hatlabs/SH-wg-hardware/README.md

# Sailor Hat WiFi Gateway

This repository contains the Sailor Hat WiFi Gateway (SH-wg) hardware design. SH-wg is a purpose-built NMEA 2000 WiFi gateway device.
