hatlabs/SH-wg-hardware/3d_models/m12_pcb_connector_1440054.stp

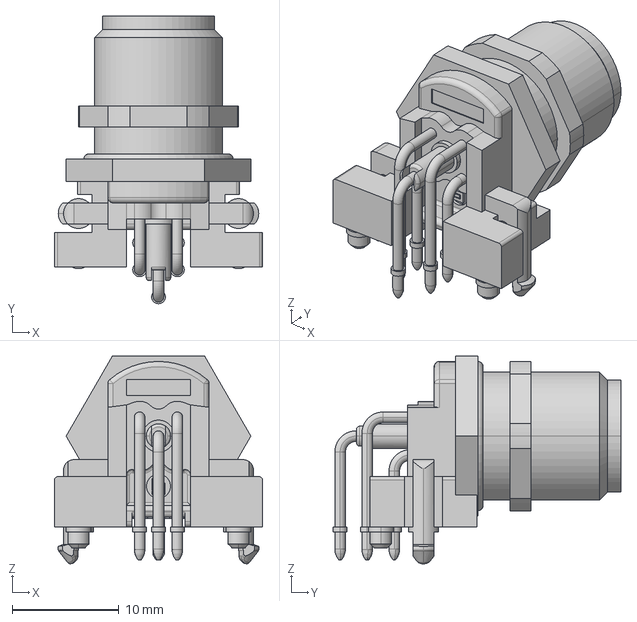
[picture p1: CAD file, 2022-01-28]
3d_models/m12_pcb_connector_1440054.stp
19.5 x 27.0 x 19.5 mm
