hatlabs/SH-wg-hardware/SH-wg.kicad_pcb

## KiCad design SH-wg.kicad_pcb (2022-03-17)

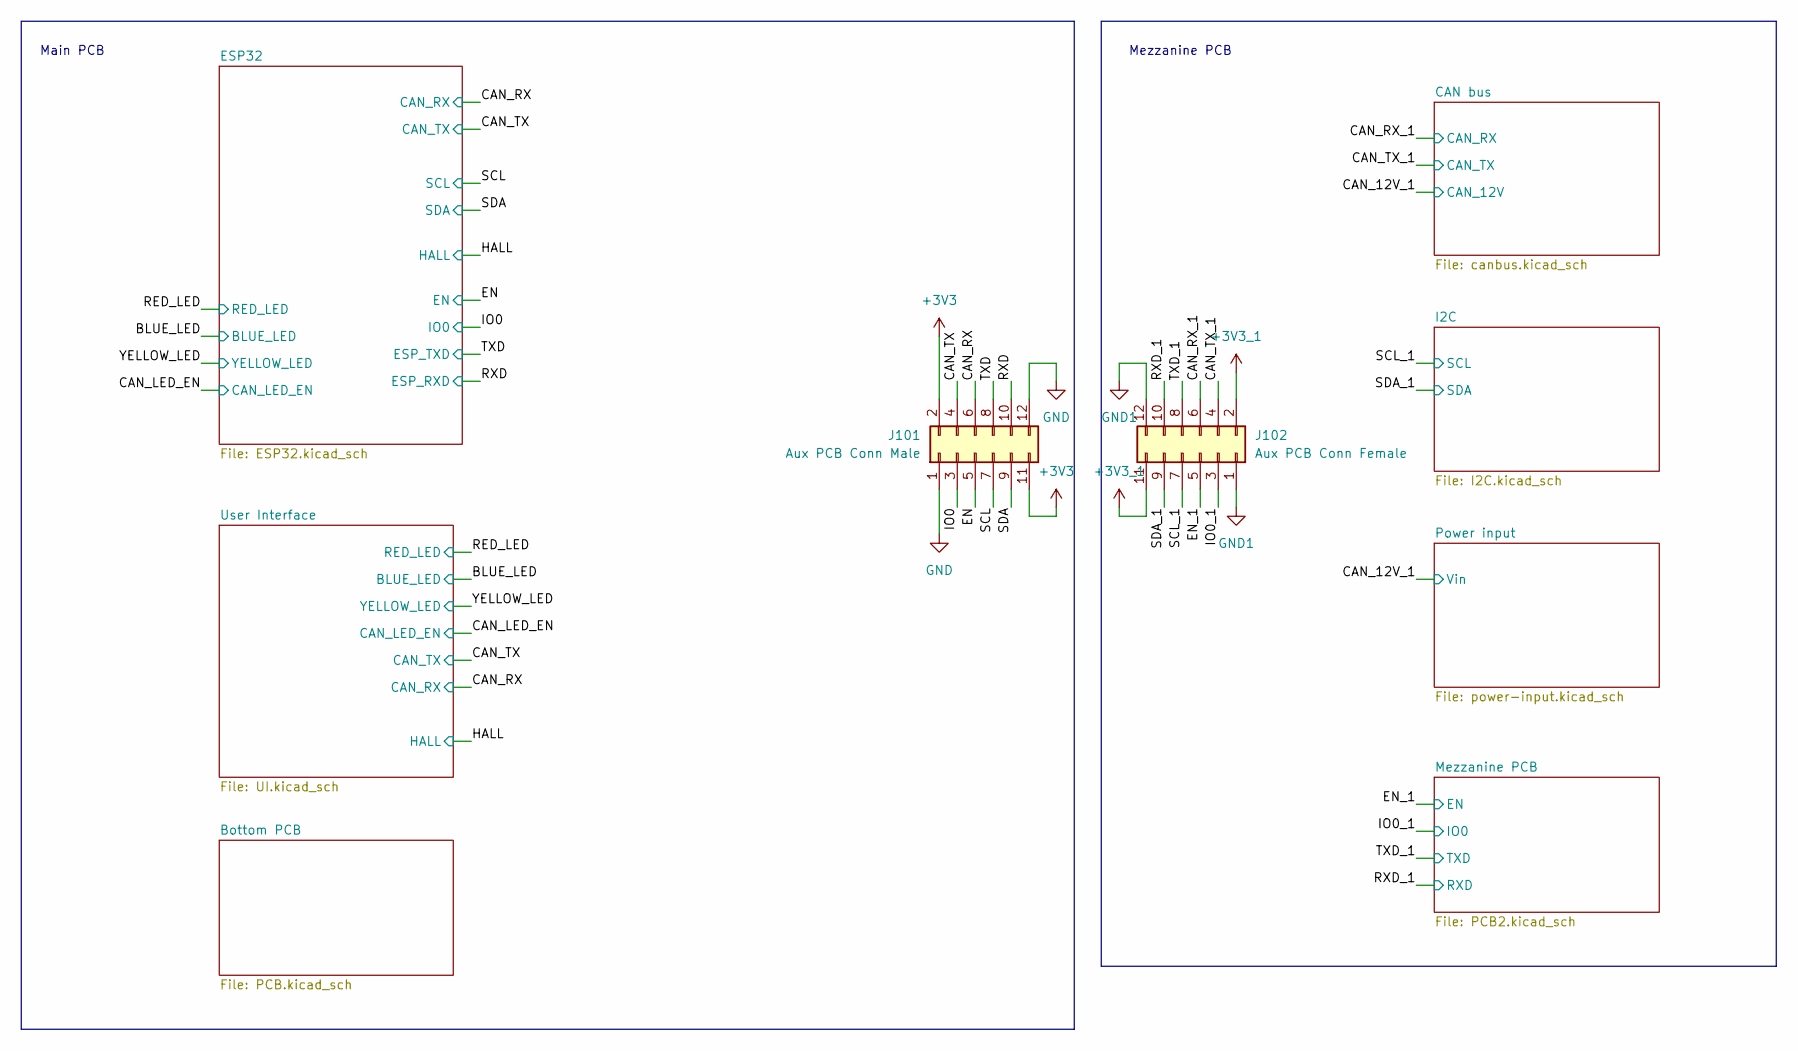
[picture p2: schematic SH-wg.kicad_sch, Sailor Hat WiFi Gateway]

Parts:
J101: Aux PCB Conn Male; PinHeader_2x06_P2.54mm_Vertical; LCSC C124388
J102: Aux PCB Conn Female; PinSocket_2x06_P2.54mm_Vertical; LCSC C36191

Connections:
+3V3_1: J102.2, J102.11; also elsewhere on the board
/CAN_RX: J101.6; also elsewhere on the board
/CAN_RX_1: J102.6; also elsewhere on the board
/CAN_TX: J101.4; also elsewhere on the board
/CAN_TX_1: J102.4; also elsewhere on the board
/EN: J101.5; also elsewhere on the board
/EN_1: J102.5; also elsewhere on the board
/IO0: J101.3; also elsewhere on the board
/IO0_1: J102.3; also elsewhere on the board
/RXD: J101.10; also elsewhere on the board
/RXD_1: J102.10; also elsewhere on the board
/SCL: J101.7; also elsewhere on the board
/SCL_1: J102.7; also elsewhere on the board
/SDA: J101.9; also elsewhere on the board
/SDA_1: J102.9; also elsewhere on the board
/TXD: J101.8; also elsewhere on the board
/TXD_1: J102.8; also elsewhere on the board
GND: J101.1, J101.12; also elsewhere on the board
GND1: J102.1, J102.12; also elsewhere on the board

Notes on the sheet:
Mezzanine PCB
Main PCB

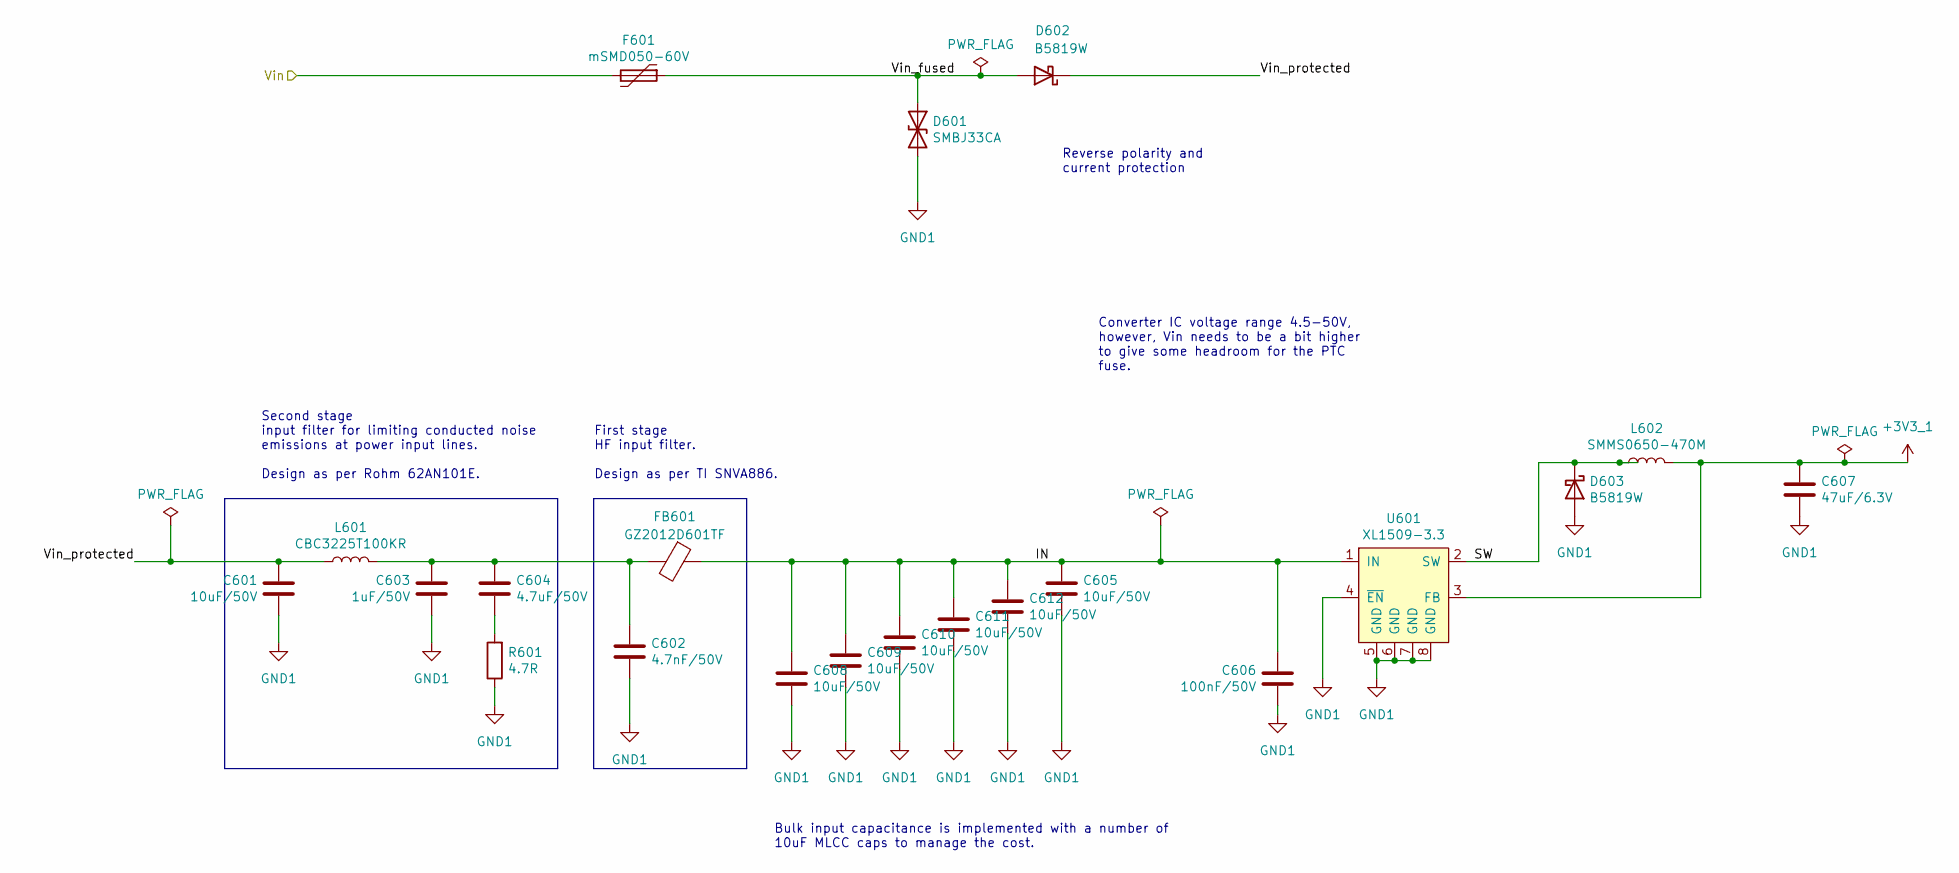
[picture p3: schematic power-input.kicad_sch, Sailor Hat WiFi Gateway]

Parts:
C601, C605, C608, C609, C610, C611, C612: 10uF/50V; C_1206_3216Metric; LCSC C13585
C602: 4.7nF/50V; C_0402_1005Metric; LCSC C1538
C603: 1uF/50V; C_0805_2012Metric; LCSC C215803
C604: 4.7uF/50V; C_1206_3216Metric; LCSC C29823
C606: 100nF/50V; C_0402_1005Metric; LCSC C307331
C607: 47uF/6.3V; C_1206_3216Metric; LCSC C96123
D601: SMBJ33CA; D_SMB; LCSC C114000
D602, D603: B5819W; D_SOD-123F; LCSC C8598
F601: mSMD050-60V; Fuse_1812_4532Metric; LCSC C70113
FB601: GZ2012D601TF; L_0805_2012Metric; LCSC C1017
L601: CBC3225T100KR; L_1210_3225Metric; LCSC C90321
L602: SMMS0650-470M; SMMS0650-1R0M; LCSC C149588
R601: 4.7R; R_0603_1608Metric; LCSC C23164
U601: XL1509-3.3; SOP-8_3.9x4.9mm_P1.27mm; LCSC C2681226

Connections:
+3V3_1: C607.1, L602.2, U601.3 (FB); also elsewhere on the board
/CAN_12V_1: F601.2; also elsewhere on the board
/Power input/IN: C605.1, C606.1, C608.1, C609.1, C610.1, C611.1, C612.1, FB601.1, U601.1 (IN)
/Power input/SW: D603.1 (K), L602.1, U601.2 (SW)
/Power input/Vin_fused: D601.1 (A1), D602.2 (A), F601.1
/Power input/Vin_protected: C601.2, D602.1 (K), L601.1
GND1: C601.1, C602.2, C603.1, C605.2, C606.2, C607.2, C608.2, C609.2, C610.2, C611.2, C612.2, D601.2 (A2), D603.2 (A), R601.1, U601.4 (~EN), U601.5 (GND), U601.6 (GND), U601.7 (GND), U601.8 (GND); also elsewhere on the board
unnamed: C602.1, C603.2, C604.1, FB601.2, L601.2
unnamed: C604.2, R601.2

Notes on the sheet:
Second stage input filter for limiting conducted noise emissions at power input lines. Design as per Rohm 62AN101E.
Converter IC voltage range 4.5-50V, however, Vin needs to be a bit higher to give some headroom for the PTC fuse.
First stage HF input filter. Design as per TI SNVA886.
Bulk input capacitance is implemented with a number of 10uF MLCC caps to manage the cost.
Reverse polarity and current protection

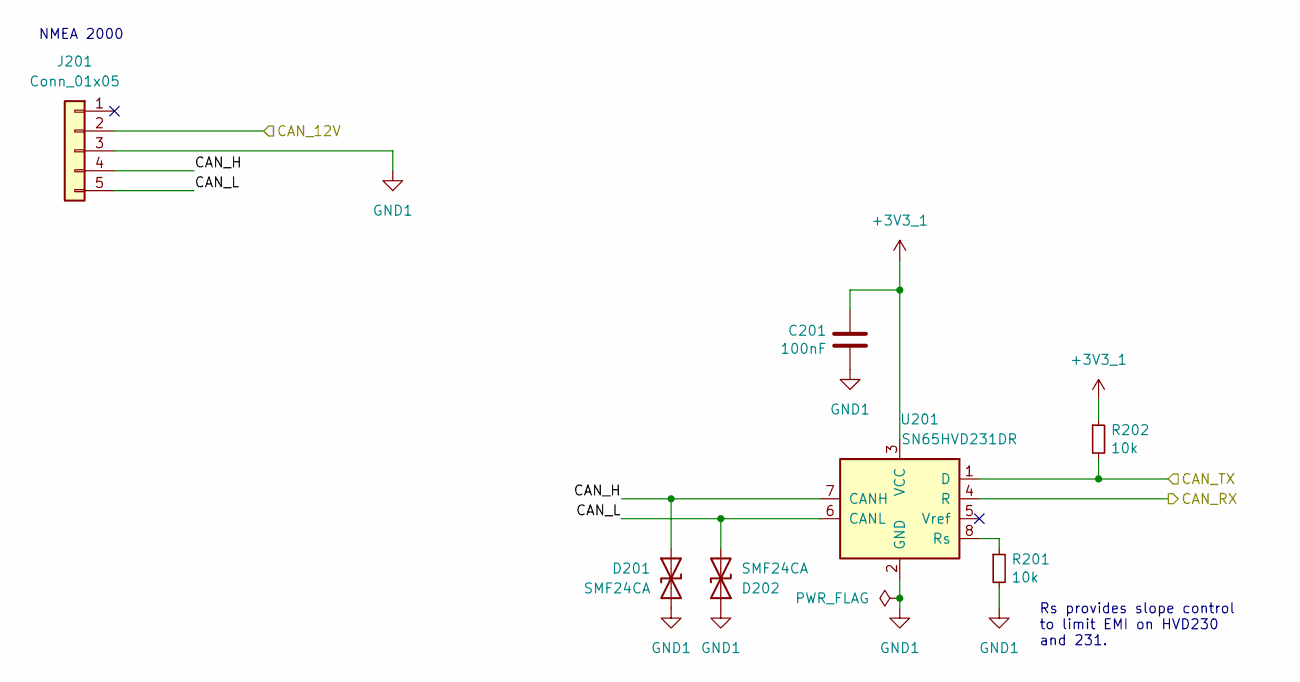
[picture p4: schematic canbus.kicad_sch, Sailor Hat WiFi Gateway]

Parts:
C201: 100nF; C_0402_1005Metric; LCSC C1525
D201, D202: SMF24CA; D_SOD-123F; LCSC C353294
J201: Conn_01x05; M12-5A_Male_Horizontal_PCB_Hysik
R201, R202: 10k; R_0402_1005Metric; LCSC C25744
U201: SN65HVD231DR; SOIC-8_3.9x4.9mm_P1.27mm; LCSC C129257

Connections:
+3V3_1: C201.1, R202.1, U201.3 (VCC); also elsewhere on the board
/CAN bus/CAN_H: D201.1 (A1), J201.4, U201.7 (CANH)
/CAN bus/CAN_L: D202.2 (A2), J201.5, U201.6 (CANL)
/CAN_12V_1: J201.2; also elsewhere on the board
/CAN_RX_1: U201.4 (R); also elsewhere on the board
/CAN_TX_1: R202.2, U201.1 (D); also elsewhere on the board
GND1: C201.2, D201.2 (A2), D202.1 (A1), J201.3, R201.2, U201.2 (GND); also elsewhere on the board
unnamed: R201.1, U201.8 (Rs)

Notes on the sheet:
Rs provides slope control to limit EMI on HVD230 and 231.
NMEA 2000

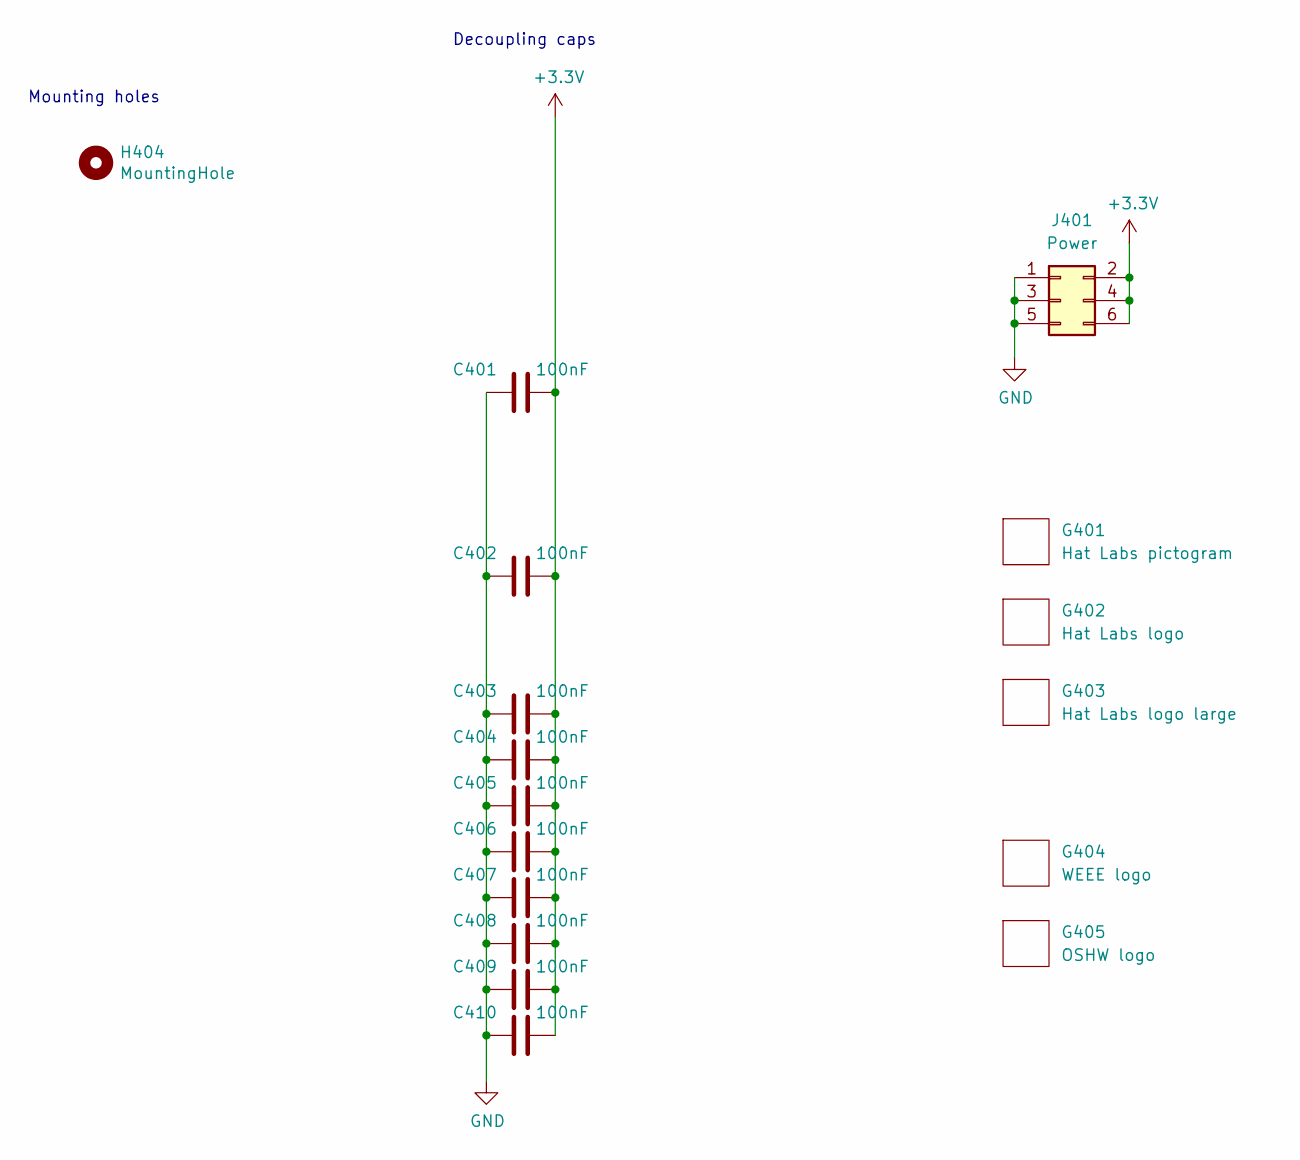
[picture p5: schematic PCB.kicad_sch, Sailor Hat WiFi Gateway]

Parts:
C401, C402, C403, C404, C405, C406, C407, C408, C409, C410: 100nF; C_0402_1005Metric; LCSC C1525
G401: Hat Labs pictogram; HL_pictogram_6.3mm
G402: Hat Labs logo; Hat_Labs_20mm
G403: Hat Labs logo large; Hat_Labs_25.4mm
G404: WEEE logo; WEEE-Logo_5.6x8mm_SilkScreen
G405: OSHW logo; OSHW-Logo2_9.8x8mm_SilkScreen
H404: MountingHole; MountingHole_3.2mm_M3_no_copper
J401: Power; PinHeader_2x03_P2.54mm_Vertical; LCSC C65114

Connections:
GND: C401.1, C402.1, C403.1, C404.1, C405.1, C406.1, C407.1, C408.1, C409.1, C410.1, J401.1, J401.3, J401.5; also elsewhere on the board

Notes on the sheet:
Mounting holes
Decoupling caps

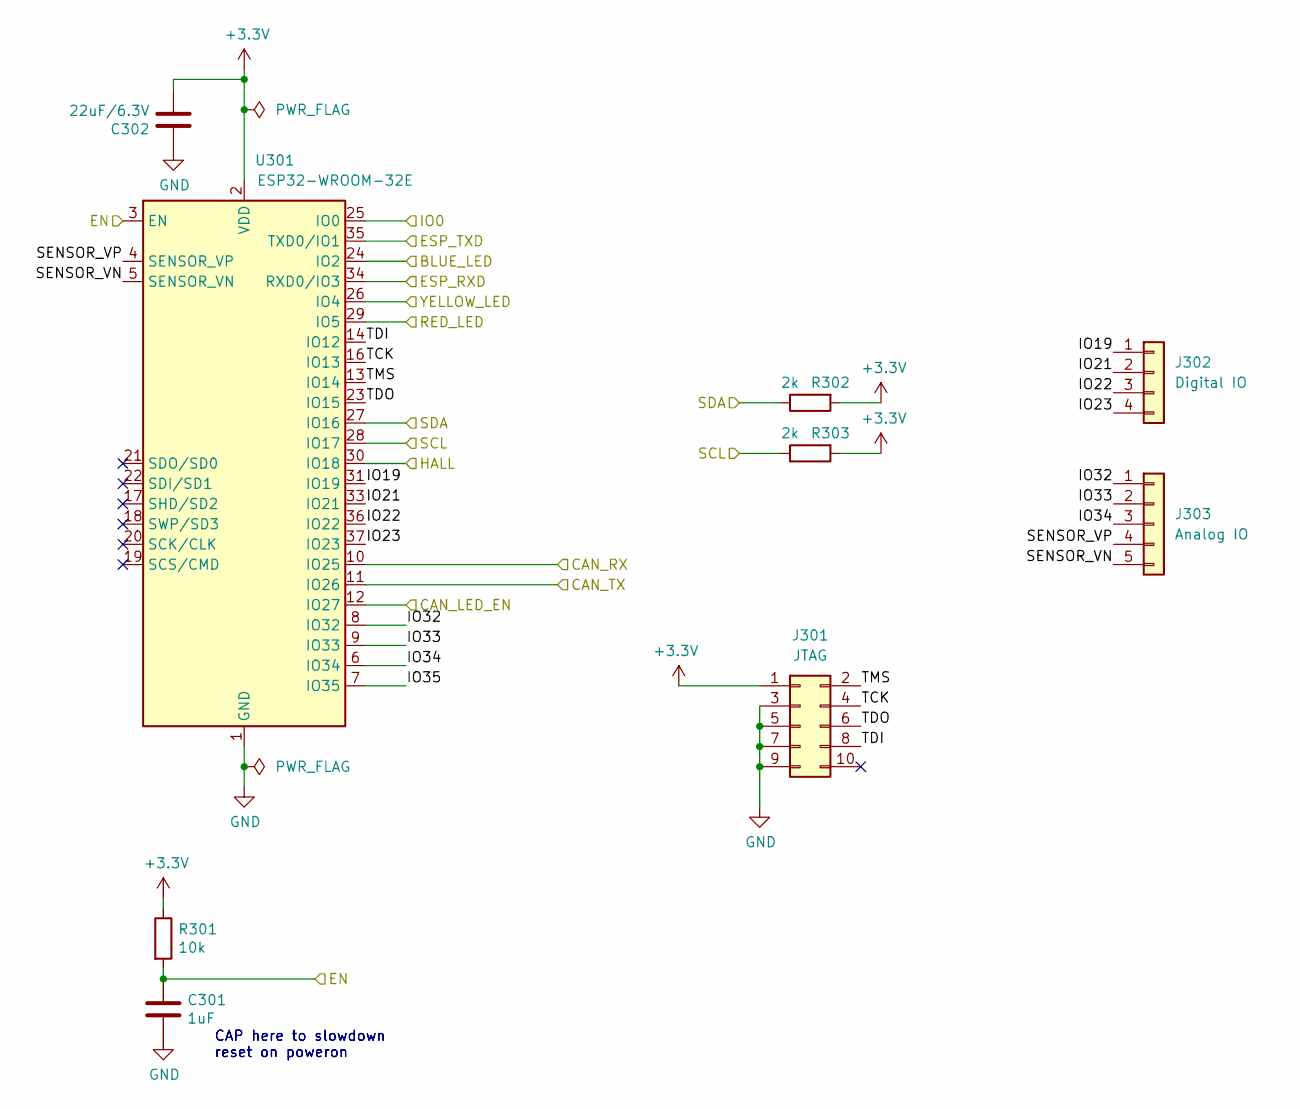
[picture p6: schematic ESP32.kicad_sch, Sailor Hat WiFi Gateway]

Parts:
C301: 1uF; C_0402_1005Metric; LCSC C52923
C302: 22uF/6.3V; C_0603_1608Metric; LCSC C59461
J301: JTAG; IDC-Header_2x05_P2.54mm_Vertical; LCSC C5665
J302: Digital IO; PinHeader_1x04_P2.54mm_Vertical; LCSC C358686
J303: Analog IO; PinHeader_1x05_P2.54mm_Vertical; LCSC C124379
R301: 10k; R_0402_1005Metric; LCSC C25744
R302, R303: 2k; R_0402_1005Metric; LCSC C4109
U301: ESP32-WROOM-32E; ESP32-WROOM-32-HandSolder; LCSC C701341

Connections:
/BLUE_LED: U301.24 (IO2); also elsewhere on the board
/CAN_LED_EN: U301.12 (IO27); also elsewhere on the board
/CAN_RX: U301.10 (IO25); also elsewhere on the board
/CAN_TX: U301.11 (IO26); also elsewhere on the board
/EN: C301.1, R301.2, U301.3 (EN); also elsewhere on the board
/ESP32/IO19: J302.1, U301.31 (IO19)
/ESP32/IO21: J302.2, U301.33 (IO21)
/ESP32/IO22: J302.3, U301.36 (IO22)
/ESP32/IO23: J302.4, U301.37 (IO23)
/ESP32/IO32: J303.1, U301.8 (IO32)
/ESP32/IO33: J303.2, U301.9 (IO33)
/ESP32/IO34: J303.3, U301.6 (IO34)
/ESP32/IO35: U301.7 (IO35)
/ESP32/SENSOR_VN: J303.5, U301.5 (SENSOR_VN)
/ESP32/SENSOR_VP: J303.4, U301.4 (SENSOR_VP)
/ESP32/TCK: J301.4, U301.16 (IO13)
/ESP32/TDI: J301.8, U301.14 (IO12)
/ESP32/TDO: J301.6, U301.23 (IO15)
/ESP32/TMS: J301.2, U301.13 (IO14)
/HALL: U301.30 (IO18); also elsewhere on the board
/IO0: U301.25 (IO0); also elsewhere on the board
/RED_LED: U301.29 (IO5); also elsewhere on the board
/RXD: U301.34 (RXD0/IO3); also elsewhere on the board
/SCL: R303.1, U301.28 (IO17); also elsewhere on the board
/SDA: R302.1, U301.27 (IO16); also elsewhere on the board
/TXD: U301.35 (TXD0/IO1); also elsewhere on the board
/YELLOW_LED: U301.26 (IO4); also elsewhere on the board
GND: C301.2, C302.1, J301.3, J301.5, J301.7, J301.9, U301.1 (GND), U301.15 (GND), U301.38 (GND), U301.39 (GND); also elsewhere on the board

Notes on the sheet:
CAP here to slowdown reset on poweron

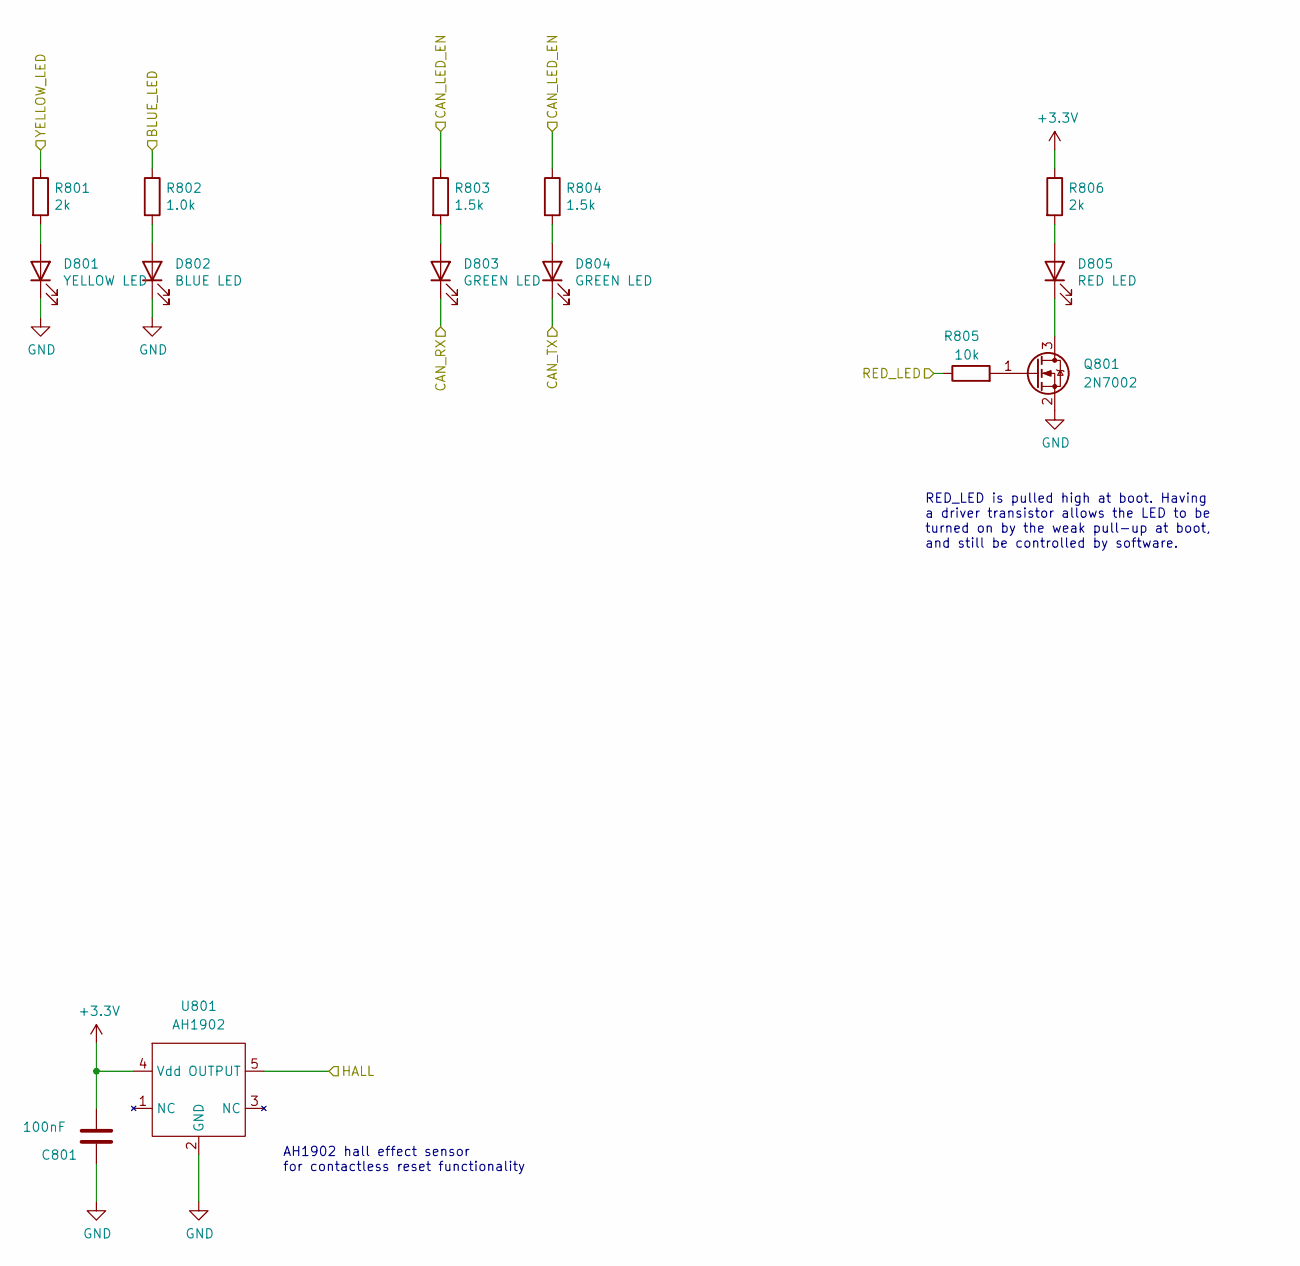
[picture p7: schematic UI.kicad_sch, Sailor Hat WiFi Gateway]

Parts:
C801: 100nF; C_0402_1005Metric; LCSC C1525
D801: YELLOW LED; LED_0603_1608Metric; LCSC C72038
D802: BLUE LED; LED_0603_1608Metric; LCSC C72041
D803, D804: GREEN LED; LED_0603_1608Metric; LCSC C72043
D805: RED LED; LED_0603_1608Metric; LCSC C2286
Q801: 2N7002; SOT-23; LCSC C8545
R801, R806: 2k; R_0402_1005Metric; LCSC C4109
R802: 1.0k; R_0402_1005Metric; LCSC C11702
R803, R804: 1.5k; R_0402_1005Metric; LCSC C25867
R805: 10k; R_0402_1005Metric; LCSC C25744
U801: AH1902; SOT-553; LCSC C239188

Connections:
/BLUE_LED: R802.1; also elsewhere on the board
/CAN_LED_EN: R803.1, R804.1; also elsewhere on the board
/CAN_RX: D803.1 (K); also elsewhere on the board
/CAN_TX: D804.1 (K); also elsewhere on the board
/HALL: U801.5 (OUTPUT); also elsewhere on the board
/RED_LED: R805.1; also elsewhere on the board
/YELLOW_LED: R801.1; also elsewhere on the board
GND: C801.1, D801.1 (K), D802.1 (K), Q801.2 (S), U801.2 (GND); also elsewhere on the board
unnamed: D801.2 (A), R801.2
unnamed: D802.2 (A), R802.2
unnamed: D803.2 (A), R803.2
unnamed: D804.2 (A), R804.2
unnamed: D805.1 (K), Q801.3 (D)
unnamed: D805.2 (A), R806.2
unnamed: Q801.1 (G), R805.2

Notes on the sheet:
AH1902 hall effect sensor for contactless reset functionality
RED_LED is pulled high at boot. Having a driver transistor allows the LED to be turned on by the weak pull-up at boot, and still be controlled by software.

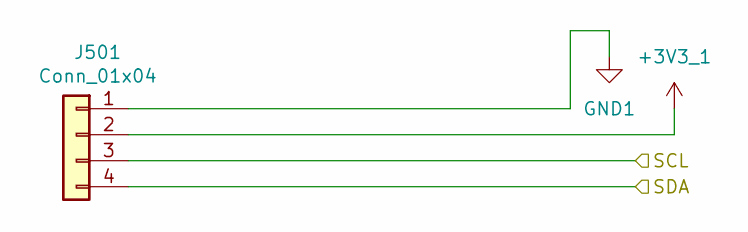
[picture p8: schematic I2C.kicad_sch, Sailor Hat WiFi Gateway]

Parts:
J501: Conn_01x04; PinSocket_1x04_P2.54mm_Vertical; LCSC C124413

Connections:
+3V3_1: J501.2; also elsewhere on the board
/SCL_1: J501.3; also elsewhere on the board
/SDA_1: J501.4; also elsewhere on the board
GND1: J501.1; also elsewhere on the board

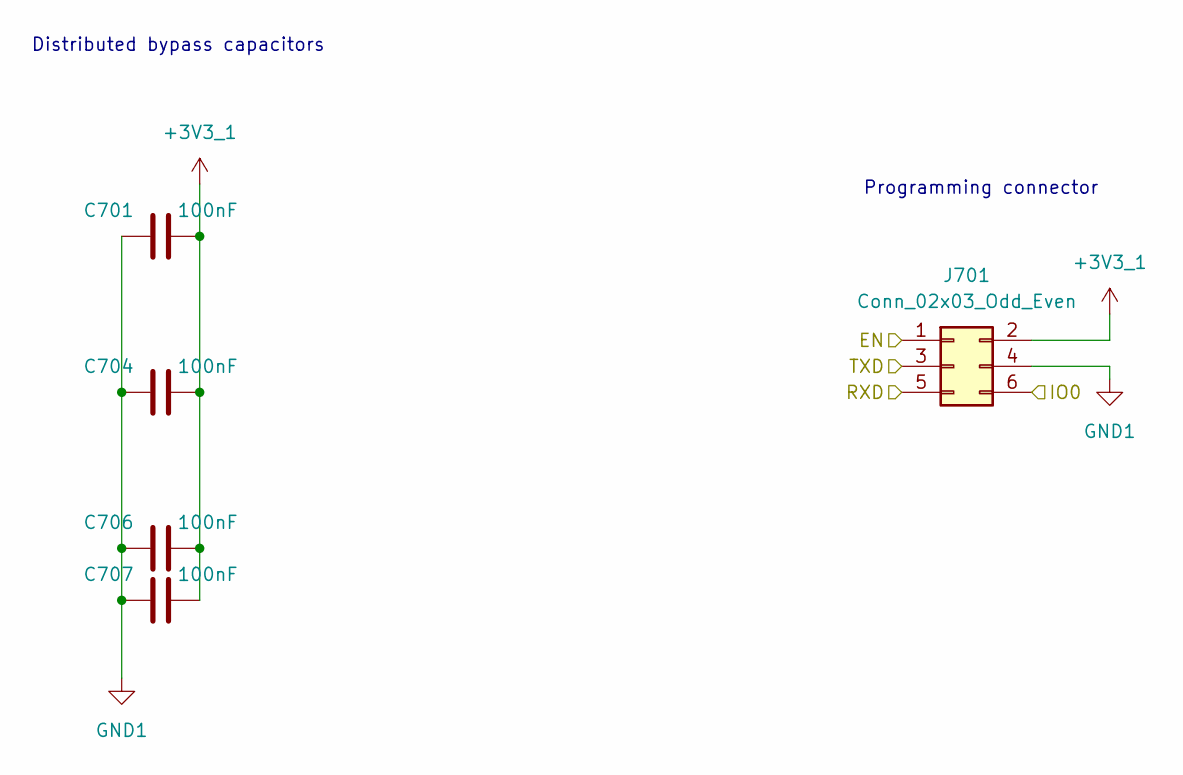
[picture p9: schematic PCB2.kicad_sch, Sailor Hat WiFi Gateway]

Parts:
C701, C704, C706, C707: 100nF; C_0402_1005Metric; LCSC C1525
J701: Conn_02x03_Odd_Even; PinHeader_2x03_P2.54mm_Vertical; LCSC C65114

Connections:
+3V3_1: C701.2, C704.2, C706.2, C707.2, J701.2; also elsewhere on the board
/EN_1: J701.1; also elsewhere on the board
/IO0_1: J701.6; also elsewhere on the board
/RXD_1: J701.5; also elsewhere on the board
/TXD_1: J701.3; also elsewhere on the board
GND1: C701.1, C704.1, C706.1, C707.1, J701.4; also elsewhere on the board

Notes on the sheet:
Programming connector
Distributed bypass capacitors

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
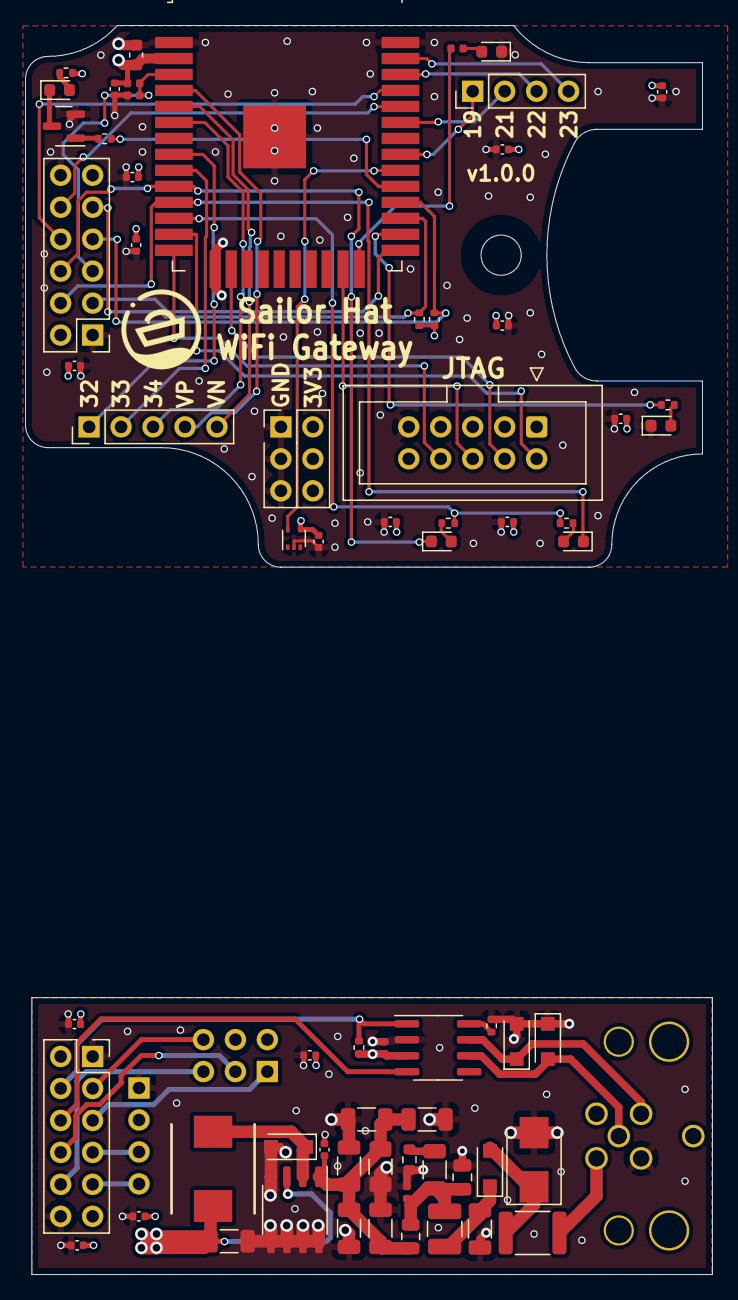
[picture p10: board SH-wg.kicad_pcb from above]

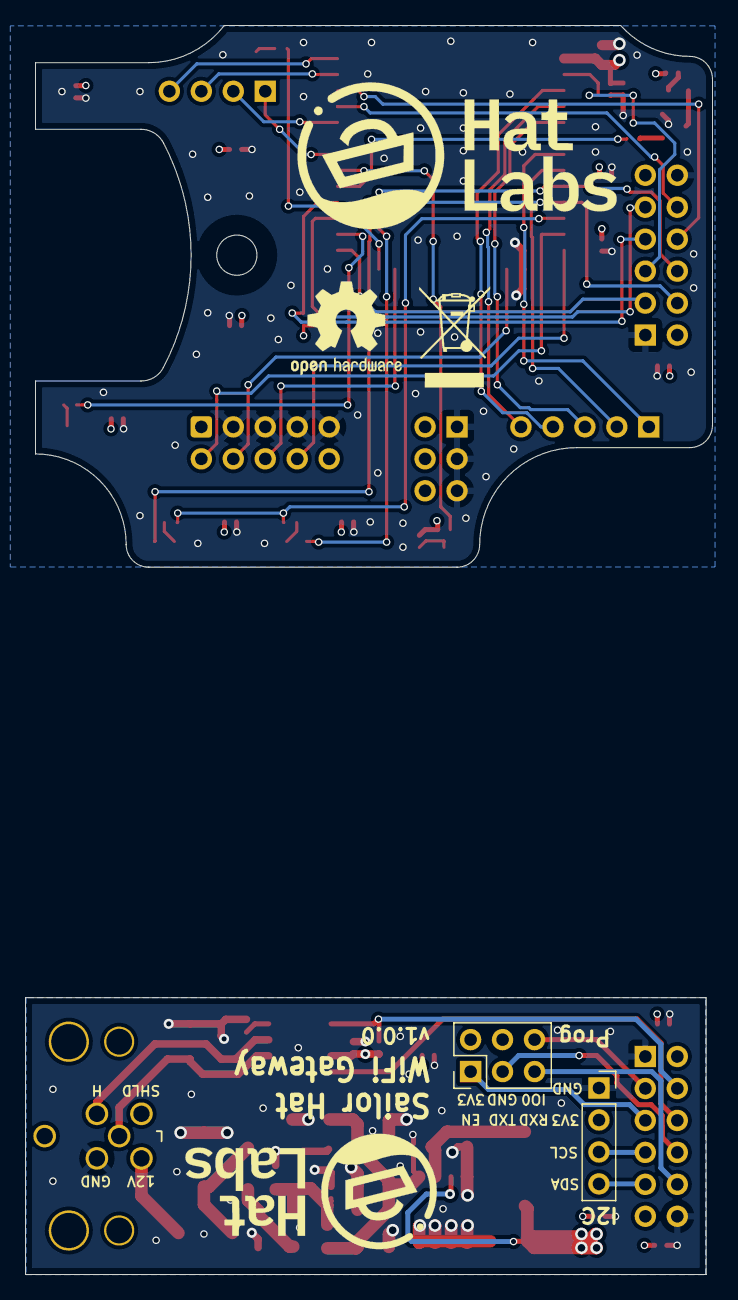
[picture p11: board SH-wg.kicad_pcb from below]

Board: 4 copper layers, 54.6 x 99.2 mm, 76 parts (6 on the bottom side), 55 nets.
