hatlabs/SH-wg-hardware/(commit log)

2022-01-26 Rename and update layout
    [ESP32.kicad_sch, I2C.kicad_sch, IOHeader.sch, PCB.kicad_sch, PCB.sch, PCB2.kicad_sch, SH-ESP32-Blank.kicad_pcb, SH-ESP32-Blank.sch]
2022-01-26 Add headers & LEDs
    [ESP32.kicad_sch, PCB.kicad_sch, SH-wg.kicad_pcb, SH-wg.kicad_sch, UI.kicad_sch]
2022-01-28 Finish 0.1.0 design
    [ESP32.kicad_sch, I2C.kicad_sch, PCB.kicad_sch, PCB2.kicad_sch, SH-wg.kicad_pcb, SH-wg.kicad_sch, UI.kicad_sch, canbus.kicad_sch]
2022-01-30 Prepare final 0.1.0 proto
    [PCB.kicad_sch, SH-wg.kicad_pcb, SH-wg.kicad_sch, UI.kicad_sch, canbus.kicad_sch, power-input.kicad_sch]
2022-02-07 Add a pull-up resistor to CAN TX line
    [SH-wg.kicad_pcb, SH-wg.kicad_sch, canbus.kicad_sch]
2022-02-21 Add copper clearance around the mounting hole
    Also make the M12 connector opening 1.5mm wider.
    [PCB.kicad_sch, SH-wg.kicad_pcb, SH-wg.kicad_sch]
2022-02-23 Update the design based on the test results
    [PCB2.kicad_sch, SH-wg.kicad_pcb, SH-wg.kicad_sch, canbus.kicad_sch, power-input.kicad_sch]
2022-02-23 Bump the board version, improve silkscreens
    [ESP32.kicad_sch, I2C.kicad_sch, PCB.kicad_sch, PCB2.kicad_sch, SH-wg.kicad_pcb, SH-wg.kicad_sch, UI.kicad_sch, canbus.kicad_sch]
2022-02-24 Update LED resistor values, improve PCB edge clearance
    [SH-wg.kicad_pcb, SH-wg.kicad_sch, UI.kicad_sch, power-input.kicad_sch]
2022-02-24 Chore: C301 value: 1uf -> 1uF
    [ESP32.kicad_sch, SH-wg.kicad_pcb, SH-wg.kicad_sch]
2022-03-17 Bump the version number
    [ESP32.kicad_sch, I2C.kicad_sch, PCB.kicad_sch, PCB2.kicad_sch, SH-wg.kicad_pcb, SH-wg.kicad_sch, UI.kicad_sch, canbus.kicad_sch]
2022-03-17 Adjust tab locations
    [SH-wg.kicad_pcb]
2022-03-17 Change CAN transceiver according to availability
    [SH-wg.kicad_pcb, canbus.kicad_sch]
2022-03-17 Add scripts for panelizing the PCBs
2022-03-17 Tweak tab locations
    [SH-wg.kicad_pcb]
2022-03-17 Update TVS diode LCSC part number
    [SH-wg.kicad_pcb, canbus.kicad_sch]
