hatlabs/SH-wg-hardware/(notices)

Notices in the files:
ESP32.kicad_sch:
https://creativecommons.org/licenses/by-sa/4.0
SH-wg is licensed under CC BY-SA 4.0.
SH-wg.kicad_pcb:
https://creativecommons.org/licenses/by/4.0
SH-wg is licensed under CC BY 4.0.
USB.kicad_sch:
SH-ESP32 is licensed under CC BY-SA 4.0.
